syanao-coder/cat-toy/README.md

# cat-toy — 猫を見つけて、その前方をレーザーで照らす自動おもちゃ

壁の高い位置に取り付けたカメラで猫を見つけ、パン・チルトのサーボで動かすレーザーを**猫の少し前方**に照らして遊ばせます。
猫の認識は常時起動している **NAS のコンテナ**（GPU 対応）で行い、壁に付けるのは安価な**カメラ付き ESP32** だけです。
スマホのホーム画面に追加できる操作画面から ON/OFF できます。

```
 壁の上（部品代 5 千円前後）                              NAS（QNAP Container Station など）
┌────────────────────────────┐   映像（Wi-Fi）   ┌────────────────────────────────────┐
│ カメラ付き ESP32-S3         │ ───────────────► │ ① YOLO で猫・人を検出（GPU）          │
│  ├ カメラ（固定・部屋全体） │                  │ ② 猫の位置と速度を推定（遅れも補正）   │
│  └ パン・チルト＋レーザー   │ ◄─────────────── │ ③ 遊び方を決める（50 Hz）             │
└────────────────────────────┘   狙い・点灯       │ ④ 画像上の狙い → サーボの角度         │
                                                  │ ⑤ スマホ用の操作画面                  │
                                                  └────────────────────────────────────┘
```

## 特徴

- **猫の前方を狙う**: 猫の速度から進む向きを推定し、その先に光点を置く。止まっている猫には、最後に向いていた方向の少し先で誘う。
- **獲物らしい動き**: 前を逃げる・素早く逃げて止まる・ちょろちょろ動く・一瞬隠れて別の場所に現れる、を組み合わせる。
  飛びかかってきたら基本は逃げるが、ときどきわざと捕まえさせる。
- **安全装置**: 猫の体の周り（目を含む）には照射しない／人が写っている間は消灯／遊ぶ範囲を床の指定範囲に限定／映像の上で囲んだ禁止エリアには照射しない／
  1 回の遊びは 10 分まで → 30 分休憩／動作時間帯の指定／連続点灯時間の上限／
  通信が 0.3 秒途絶えたら ESP32 が自分でレーザーを消す。
- **自動キャリブレーション**: レーザーを格子状に点滅させてカメラで位置を測り、「画像の位置 → サーボ角度」と映像の遅れを自動で求める。
- **スマホで操作**: ON/OFF・状態・今日遊んだ時間・ライブ映像。ESP32 の BOOT ボタンでも ON/OFF できる。
- **設置したまま更新**: ESP32 のファームウェアはネットワーク越しに書き換えられ、起動に失敗したら自動で前の版に戻る。
  Wi-Fi が変わっても、設定用のアクセスポイントからつなぎ直せる。
- **NAS に優しい**: OFF・休憩中は認識を止め、猫がいない間は 1 秒に 1 回だけ確認する。認識は GPU（なければ自動で CPU）。

## ⚠️ 安全について（必ずお読みください）

- **レーザーは出力 1mW 以下（Class 2 以下）のものを使ってください。** 電子工作用のレーザーモジュールは 5mW 品が多く危険です。
- ソフトウェアで猫の体の周りを避けていますが、検出漏れや遅れはゼロにはできません。
  照射範囲（サーボの可動範囲と `play_area`）は**床だけ**に絞り、人や猫の目の高さに届かないようにしてください。
- 最初の数日は必ず人が見ている所で動かし、猫の反応と動作を確認してから無人運転にしてください。
- 鏡・窓・ガラスなど反射する物に当たらないように設置してください。届いてしまう物は、操作画面で**禁止エリア**の枠で囲んでください。
  禁止エリアもカメラの認識と位置合わせの精度に頼っているので、可動範囲で届かないようにするのがいちばん確実です。
- レーザー遊びは「捕まえられない」ことで猫がストレスを溜めることがあると言われます。
  `finish_point` に本物のおもちゃやおやつを置き、最後はそこで「捕まえて」終われるようにするのがおすすめです。

## 作り方

| 手順 | 内容 | 説明 |
| --- | --- | --- |
| 1. 部品をそろえて組み立てる | ESP32-S3 CAM・OV2640 120°・MG90S ×2・パン・チルト台・1mW レーザーなど | [docs/hardware.md](docs/hardware.md)（プリント基板にするなら [docs/pcb.md](docs/pcb.md)） |
| 2. ESP32 に書き込む | Arduino IDE で `firmware/cattoy_esp32` を書き込む | [firmware/README.md](firmware/README.md) |
| 3. NAS にアプリを作る | Container Station に [YAML](docker/qnap-app.yml) を貼り付ける（2 行だけ書き換え） | [docs/nas.md](docs/nas.md) の 1〜2 |
| 4. 調整する | 操作画面で可動範囲の調整 → 位置合わせ（キャリブレーション） | [docs/nas.md](docs/nas.md) の 3 |
| 5. スマホから使う | `http://<NAS の IP>:8090/` をホーム画面に追加 | [docs/nas.md](docs/nas.md) の 4 |

NAS がない場合は、Raspberry Pi 1 台で完結させる構成でも動きます（[docs/raspberry-pi.md](docs/raspberry-pi.md)）。

## コマンド

| コマンド | 内容 |
| --- | --- |
| `cattoy run` | 遊ばせる（本番）。操作画面も出す |
| `cattoy calibrate [-y] [--web PORT]` | カメラとサーボの対応付けと映像の遅れを自動で測る（猫と人がいない状態で） |
| `cattoy hw-test [--laser]` | 配線確認（レーザーの点滅とサーボを可動範囲の端まで動かす） |
| `cattoy aim --angles PAN TILT` / `--point X Y` | 指定した角度・画像上の位置を照らす |
| `cattoy snapshot` | 目盛り付きのカメラ画像を保存する |
| `cattoy esp32-update FILE` | ESP32 のファームウェアをネットワーク越しに書き換える（失敗したら自動で前の版に戻る） |
| `cattoy esp32-status` / `esp32-reboot` | ESP32 の状態を見る／再起動する |
| `cattoy esp32-wifi SSID` | ESP32 がつなぐ Wi-Fi を変える |

コンテナでは `docker compose -f docker/compose.yml run --rm cattoy <コマンド>` で実行します。

## 遊び方の調整

`config.toml` の `[play]` で変えられます（すべての項目と既定値は [cattoy/config.py](cattoy/config.py)）。
距離と速さは**猫の体長を 1 とした倍率**なので、設置の高さやカメラの画角が変わってもそのまま使えます。

| 項目 | 既定値 | 内容 |
| --- | --- | --- |
| `session_max_s` / `cooldown_s` | 600 / 1800 | 1 回の遊びの長さと、その後の休憩（秒） |
| `active_hours` | `"07:00-23:00"` | 動作する時間帯（`""` で常時） |
| `start_delay_s` | 1.5 | 猫がこの秒数見え続けたら開始（誤検出対策） |
| `keepout_margin` | 0.35 | 猫の外接矩形をこれだけ広げた範囲には照射しない |
| `lead_distance` | 1.6 | 走る猫のどれだけ前に置くか |
| `lure_distance` | 2.0 | 止まった猫のどれだけ前で誘うか |
| `creep_speed` / `move_speed` / `dart_speed` | 0.8 / 2.5 / 7.0 | ゆっくり／ふつう／素早い動きの速さ（体長/秒） |
| `flee_probability` | 0.7 | 飛びかかられたとき逃げる確率（残りはわざと捕まえさせる） |
| `person_safety` | true | 人が写っている間は消灯 |
| `play_area` / `finish_point` | 自動 / なし | 遊ぶ範囲（多角形）と、終わりに誘導する場所 |
| `no_go_zones` / `no_go_margin` | なし / 0.02 | レーザーを当てない四角（窓・テレビなど）と、その周りに空ける余白（画像の幅に対する割合）。**操作画面のライブ映像の上で枠を置いて設定できる** |

## 実機なしで試す（PC）

USB カメラや猫の動画ファイルを使って、検出と遊び方の判断をブラウザで確認できます（サーボとレーザーは動かしません）。

```bash
pip install -e '.[desktop]'
cat > config.toml <<'EOF'
[camera]
backend = "opencv"
device = 0              # 動画ファイルなら "cat.mp4"
[servo]
backend = "mock"
[laser]
backend = "mock"
[play]
active_hours = ""
EOF
cattoy run      # http://localhost:8080/ を開く
```

検出モデルは、コンテナを使わない場合だけ自分で用意します（`models/yolo11n.onnx` に置く）。

```bash
pip install ultralytics
yolo export model=yolo11n.pt format=onnx imgsz=320
```

> Ultralytics のモデルは AGPL-3.0 ライセンスです。個人で使う分には問題ありません。

## 開発

```bash
pip install -e '.[dev]'
pytest
```

テストでは次のことを確認しています。
- レーザー点を追いかける仮想の猫で、点灯中は必ず猫から離れた位置・遊ぶ範囲の中を照らしていること
- 仮想の部屋（壁掛けのパン・チルト＋広角カメラ）での自動キャリブレーションの精度と、映像の遅れの測定
- ESP32 との通信（ローカルの UDP / HTTP サーバー相手）、本物の onnxruntime での検出
- 本体ループの ON/OFF・待機中の認識間隔・操作画面の API

| ファイル | 役割 |
| --- | --- |
| `cattoy/app.py` | 本体ループ（映像スレッド＋50 Hz の制御ループ、ON/OFF、負荷の段階切り替え） |
| `cattoy/behavior.py` | 遊び方のステートマシン（狙いの位置・点灯の判断、安全装置） |
| `cattoy/tracker.py` | 猫の追跡（位置・速度の推定と外挿） |
| `cattoy/detector.py` | YOLO（ONNX）による猫・人の検出（GPU / CPU） |
| `cattoy/calibration.py` | 画像座標 ⇔ サーボ角度の対応付け、レーザー点の検出 |
| `cattoy/calibrate.py` | 自動キャリブレーションの手順と映像の遅れの測定 |
| `cattoy/esp32.py` | ESP32 との通信（映像の受信、サーボ・レーザーの指令） |
| `cattoy/firmware.py` | ESP32 の遠隔メンテナンス（ファームウェアの書き換え・再起動・Wi-Fi 設定） |
| `cattoy/hardware.py` | カメラ・サーボ・レーザーの共通部分（Raspberry Pi 用とモックを含む） |
| `cattoy/preview.py` / `webpage.py` | 操作画面とライブ映像 |
| `cattoy/cli.py` | コマンド |
| `firmware/cattoy_esp32/` | ESP32 のファームウェア（Arduino） |
| `docker/` | コンテナ（GPU 版・CPU 版）、Container Station 用の YAML、compose 設定 |
| `.github/workflows/` | テストと、コンテナイメージの自動作成（ghcr.io） |

## 今後の拡張案

- **閉ループ補正**: 遊んでいる最中もレーザー点をカメラで確かめ、狙いのずれを補正する。
- **多頭飼い対応**: 現在は 1 匹を追いかける（2 匹以上いるときは直前に追っていた猫を優先）。
