syanao-coder/cat-toy/docs/hardware.md

# ハードウェア（部品・配線・設置）― ESP32 構成

壁に付けるのは「カメラ付き ESP32 ＋ パン・チルト台に載せたレーザー」だけです。猫の認識は NAS のコンテナが行います。

```
  ┌─────────── ケース（壁に固定） ───────────┐
  │  [カメラ] ← 固定。部屋全体を見渡す          │
  │  [ESP32-S3 ボード]                          │
  │  [パン・チルト台] ← ここだけ動く            │
  │      └ [レーザー]                          │
  └─────────────────────────────────────────────┘
```

## 部品

| 部品 | 選んだもの | 数 | メモ |
| --- | --- | --- | --- |
| カメラ付きマイコン | **ESP32-S3 CAM（ESP32-S3-WROOM-1 N16R8、USB-C ×2）** | 1 | Freenove ESP32-S3-WROOM CAM 互換の配置。カメラ別売りの「Single module」で可 |
| カメラ | **OV2640 120° レンズ版（24 ピン、ケーブル 75mm）** | 1 | 赤外線カット付きの通常版（「850nm」「Night Vision」版は避ける） |
| サーボ | **MG90S（金属ギア、180°）** | 2 | 「360°（連続回転）」版は使えない。予備に 1 個あると安心 |
| パン・チルト台 | SG90 / MG90S 用 2 軸ブラケット | 1 | サーボの付属ホーンを切って合わせるのが普通 |
| レーザー | 赤色 650nm **1mW 以下** | 1 | 秋月電子「赤色ドットレーザーモジュール 8mm×19mm 1mW」を推奨（下記） |
| トランジスタ | 2SC1815 ＋ 1kΩ 抵抗 ＋ 10kΩ 抵抗 | 各 1 | レーザーの ON/OFF 用（10kΩ は起動中にレーザーが勝手に点かないようにする） |
| 電源 | 5V 2A 以上の AC アダプター | 1 | サーボ 2 個とボードをまとめて給電する |
| コンデンサ | 電解コンデンサ 470〜1000µF（10V 以上） | 1 | サーボが動き出すときの電圧低下でボードが再起動するのを防ぐ |
| 有線 LAN 用の口 | ピンヘッダー（メス）1×8 ＋ 10kΩ 抵抗 | 各 1 | 後から W5500 を挿せるようにしておく（下記「有線 LAN 用の口」） |
| その他 | ユニバーサル基板（またはプリント基板 → [pcb.md](pcb.md)）・ジャンパワイヤ・ケース・固定具 | | |
| （後から）有線 LAN | W5500 モジュール | 1 | 必要になったら足す。5V ピンのある（レギュレーター付きの）ものが扱いやすい |

### レーザーの選び方

- **必ず出力 1mW 以下（JIS / IEC の Class 1 または 2）を選んでください。**
  電子工作用の「レーザーダイオードモジュール」は 5mW（Class 3R）のものが多く、猫にも人にも危険です。
- 通販のノーブランド品は表記より出力が強いことがあります。出力が明記されている国内の電子部品店の品が確実です。
- 赤（650nm）が一般的です。猫は赤を見分けにくいとも言われますが、動く光点にはよく反応します。

## 配線

後から有線 LAN（W5500）を足せるように、**最初から「有線 LAN 用の口」（8 ピンのヘッダー）を用意しておく**配線です。
W5500 を挿さなければ今までどおり Wi-Fi で動き、挿せばケーブルを挿すだけで有線にできます（ファームウェアが自動で切り替える予定）。

### 配線図

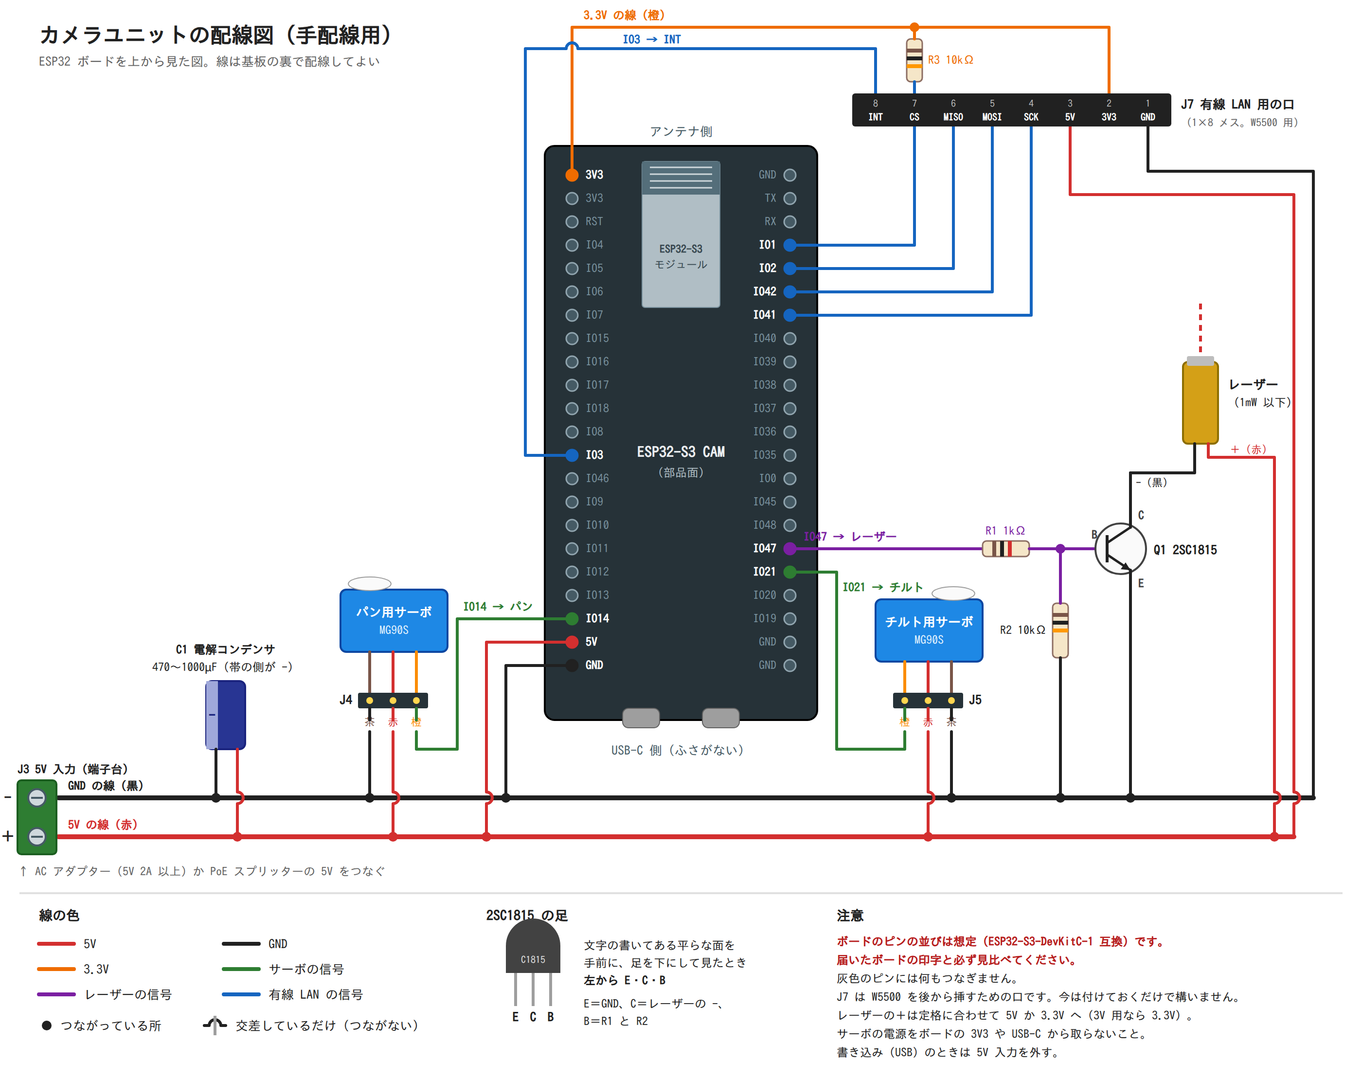
[picture p1: docs/images/wiring.png]
カメラユニットの配線図


（拡大して見たいときは [SVG 版](images/wiring.svg)。ピンの並びが違って作り直すときは `python docs/images/wiring_diagram.py`）

- 赤＝5V、黒＝GND、橙＝3.3V。**●** はつながっている所、**半円で飛び越えている所**は交差しているだけ（つながない）です。
- 下の 2 本（5V の線と GND の線）は、ユニバーサル基板の端に沿って太めの線を 2 本通し、各部品をそこへつなぐ形にすると配線が楽です。
- ボードのピンの並びは **ESP32-S3-DevKitC-1 互換の想定**です。届いたボードの印字と必ず見比べてください。

### 組み立ての順番（ユニバーサル基板）

1. **ESP32 ボード用のメスのピンヘッダー 2 列**を先に付ける。ボードを挿した状態ではんだ付けすると、列の間隔がずれない
   （はんだ付けの熱が伝わらないよう、1 列の両端だけ留めたらボードを抜いて残りを付ける）。
   ボードのアンテナ側の端は、ユニバーサル基板の外にはみ出すように置くと電波が弱まりにくい。
2. **5V の線と GND の線**を基板の端に沿って 2 本通す（太さ 0.3mm² 以上、または AWG22 程度。サーボで 2A 近く流れる）。
3. **端子台（J3）・電解コンデンサ（C1）・サーボの口（J4・J5）**を付けて、5V の線と GND の線へつなぐ。
4. **ボードの 5V・GND**（左列の下 2 本）を 5V の線と GND の線へつなぐ。
5. **信号線**（IO14・IO21・IO47）と、**レーザーの部分**（R1・R2・Q1）を付ける。信号線は細い線（AWG26〜28 やポリウレタン線）でよい。
6. **有線 LAN 用の口（J7）・R3** と、3.3V・IO1・IO2・IO3・IO41・IO42 の線を付ける。今は W5500 を挿さないので、付けておくだけで構いません。
7. **電源を入れる前に、テスターで確かめる**:
   - 5V の線と GND の線の間が導通していない（ショートしていない）
   - ボードの 5V ピン・3V3 ピン・GND ピンが、それぞれ正しい線とつながっている
   - 2SC1815 の向き（平らな面を手前に、左から E・C・B）
8. **ESP32 ボードを挿さずに 5V 入力をつなぎ**、ボードの 5V ピンの所に 5V が来ていることをテスターで確かめる。
9. 5V 入力を外してから ESP32 ボードを挿し、USB でファームウェアを書き込む（[firmware/README.md](../firmware/README.md)）。
10. USB を外して 5V 入力から動かし、操作画面の「調整」で、スライダーでサーボが動くこと・「レーザーを点ける」でレーザーが点くことを確かめる。

### 全体

```
 5V 入力（AC アダプター／PoE スプリッター）
   │
 ┌─┴──────── 中継基板 ────────────┐
 │ 5V・GND ─┬─ ESP32 ボード          │
 │          ├─ サーボ ×2            │
 │          ├─ 電解コンデンサ        │
 │          ├─ レーザー（2SC1815）   │
 │          └─ 有線 LAN 用の口       │
 │                                  │
 │ ESP32 ボード                     │
 │   GPIO14・21 → サーボの信号      │
 │   GPIO47     → レーザーの ON/OFF │
 │   GPIO41・42・2・1・3            │
 │              → 有線 LAN 用の口   │
 └──────────────┬───────────────────┘
                └─（後から）W5500 ─ LAN ケーブル
```

### 電源とサーボ

```
  5V 入力 (+) ──┬──────────────┬──────────────┬───────────────┬─── ボードの 5V ピン
                │              │              │               │
            パン用サーボ    チルト用サーボ   ＋ 電解コンデンサ   有線 LAN 用の口 3 番（5V）
              赤線            赤線         （足の長い方）
  5V 入力 (−) ──┴── 茶線 ──────┴── 茶線 ──────┴── − 側 ────────┴─── ボードの GND ピン

  ボード GPIO14 ──────────── パン用サーボのオレンジ線（信号）
  ボード GPIO21 ──────────── チルト用サーボのオレンジ線（信号）
```

- 5V 入力は、AC アダプターでも、PoE スプリッターの 5V 出力でも同じ所につなぎます。
- **GND（−）はすべてつなげます。** 電源・サーボ・ボード・トランジスタ・W5500 の GND が共通でないと動きません。
- サーボの電源はボードの 3.3V から取らないでください（電流が足りずボードが落ちます）。
  ボードの USB-C を通してサーボに給電するのも避けます（ボードの配線が電流に耐えられません）。
- コンデンサには向きがあります（足の短い方・帯の側が −）。逆につなぐと壊れます。
  サーボの近く（5V と GND が分かれる所）に付けると効きます。

### レーザー

```
  ボード GPIO47 ── 1kΩ ──┬── B ┐
                         │     │  2SC1815（NPN）
                       10kΩ    │  ※足は平らな面を正面にして左から E・C・B
                         │     │
  ボード GND ────────────┴── E ┤
  レーザー (−) ────────────── C ┘
  レーザー (+) ── 5V または 3.3V（レーザーの定格電圧に合わせる）
```

- 10kΩ はベースと GND の間に入れます。電源を入れた直後や書き込み中は GPIO47 の状態が決まらないので、
  これがないとレーザーが一瞬点くことがあります。

### 有線 LAN 用の口（W5500 を後から挿すためのヘッダー）

1×8 のメスのピンヘッダーを中継基板に付けて、次のようにボードとつないでおきます。
W5500 はジャンパワイヤ（オス‐メス）でこのヘッダーとつなぎます。

| 口の番号 | 信号 | つなぐ先（ボード側） | W5500 モジュールの表記の例 |
| --- | --- | --- | --- |
| 1 | GND | GND | GND |
| 2 | 3.3V | 3V3 | 3.3V / 3V3 / VCC |
| 3 | 5V | 5V | 5V（ないモジュールもある） |
| 4 | SCK | GPIO41 | SCK / SCLK |
| 5 | MOSI | GPIO42 | MOSI / SI |
| 6 | MISO | GPIO2 | MISO / SO |
| 7 | CS | GPIO1（**10kΩ で 3.3V へつなぐ**） | CS / SCS / SS |
| 8 | INT | GPIO3 | INT |

- **W5500 の電源は 2 番（3.3V）か 3 番（5V）のどちらか一方だけ**につなぎます。
  - 5V ピンのある（レギュレーター付きの）モジュールなら **3 番の 5V** から。ボードの 3.3V の負担が増えません。
  - 3.3V しかない小型のモジュール（W5500 Lite など）は 2 番の 3.3V から。W5500 は 130mA ほど使うので、有線のときは Wi-Fi を止めて合計を抑えます（ファームウェアで対応）。
- W5500 の RST（リセット）はつながなくて構いません（ファームウェアが通信でリセットします）。
- 7 番の CS には **10kΩ の抵抗を 3.3V との間に**入れておきます（電源を入れた瞬間に W5500 が誤動作しないように）。
- **W5500 までの線は 15cm 以内**にしてください。速い信号（20MHz）なので、長いと通信が不安定になります。
- W5500 を挿していなくても、この口は付けたままで問題ありません（ファームウェアが W5500 の有無を確かめて、なければ Wi-Fi で動きます）。

### ピンの使い方（まとめ）

| GPIO | 用途 |
| --- | --- |
| 4〜13・15〜18 | カメラ（ボード上で配線済み） |
| 14 / 21 | パン / チルト用サーボ |
| 47 | レーザー（2SC1815 経由） |
| 0 | BOOT ボタン（ON/OFF） |
| 48 | ボード上の RGB LED |
| 41 / 42 / 2 / 1 / 3 | **有線 LAN 用に予約**（SCK / MOSI / MISO / CS / INT） |
| 35〜37 | **使用禁止**（内蔵メモリ PSRAM） |
| 38〜40 | 使わない（ボードの microSD スロットにつながっている） |
| 19 / 20 | 使わない（USB-C の「USB」側） |
| 43 / 44 | 使わない（USB-C の「COM」側＝書き込み用） |
| 45 / 46 | 使わない（起動のしかたを決めるピン。つなぐ物によっては起動しなくなる） |

※ ピンの名前の位置はボードの製品によって違うことがあります。届いたら、ボードの印字で GPIO1・2・3・41・42 がピンヘッダーに出ていることを確かめてください。

### その他

- この配線をプリント基板にする手順は [pcb.md](pcb.md) にあります（EasyEDA での描き方・接続表・回路図の照合）。
- **書き込み（USB 接続）のときは 5V 入力を外しておく**と安全です。
- ON/OFF ボタンには、ボード上の **BOOT ボタン**を使います（押すたびに ON/OFF が切り替わります）。
  手の届く所に置きたい場合は、タクトスイッチを GPIO0 と GND の間に配線して延長できます
  （電源を入れる瞬間に押していると書き込みモードで起動するので注意）。

## 設置

```
     壁
     ┃ ◢ ケース（高さ 2m 以上・部屋の中央に向けて斜め下向き）
     ┃   ＼
     ┃     ＼   ← 斜めに見下ろす
     ┃       ＼
     ┗━━━━━━━━━━━━━━━━━━━━━━━  床（ここで遊ぶ）
```

- **高い壁面（部屋の角が理想）から、部屋の中央に向けて斜め下に**取り付けるのがおすすめです。
  - 物体検出モデルは普通の写真で学習しているため、真上から見下ろすより斜めから見たほうが猫を見つけやすい。
  - パン・チルト台を真下に向けると、真下付近でパンの回転が効かなくなり、狙いが不安定になる。
- **カメラは動かさず固定します。** 動くのはパン・チルト台のレーザーだけです。
  カメラ画像の座標とサーボの角度の対応表（キャリブレーション）を作るので、カメラが動くと狙いが合わなくなります。
- カメラはパン・チルト台の土台の近くに、部屋全体が写る向きで固定します。近いほど、ソファの上など床より高い場所での狙いのずれが小さくなります。
- カメラのケーブルは曲げを繰り返すと傷むので、動く部分には載せず、ケースにしっかり固定してください。
- 取り付けがずれたら `cattoy calibrate` をやり直します。
- 猫が登って届く場所・ケーブルを噛める場所は避けてください。
- 鏡・窓・テレビ・ガラスのテーブルなど、光を反射する物にレーザーが当たらない向きにします。
- Wi-Fi の電波が届く場所にしてください（操作画面に ESP32 の電波強度が出ます。-70 dBm より弱いと映像が途切れがちになります）。
  電波が弱い場合は、「有線 LAN 用の口」に W5500 を挿して有線にできます。
