syanao-coder/cat-toy/models/README.md

# 検出モデル

ここに YOLO の ONNX モデル（既定のファイル名は `yolo11n.onnx`）を置きます。
コンテナで動かす場合は同梱されているので不要です。それ以外の作り方は README.md の「実機なしで試す」を参照してください。
