syanao-coder/cat-toy/docs/images/wiring_lan.png

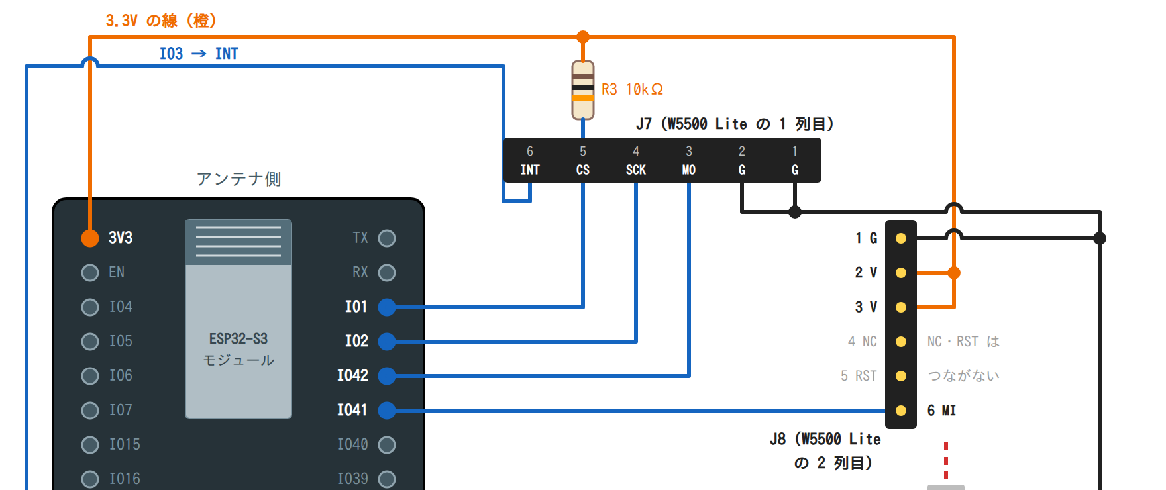
docs/images/wiring_lan.png
