syanao-coder/cat-toy/docs/images/wiring_power.png

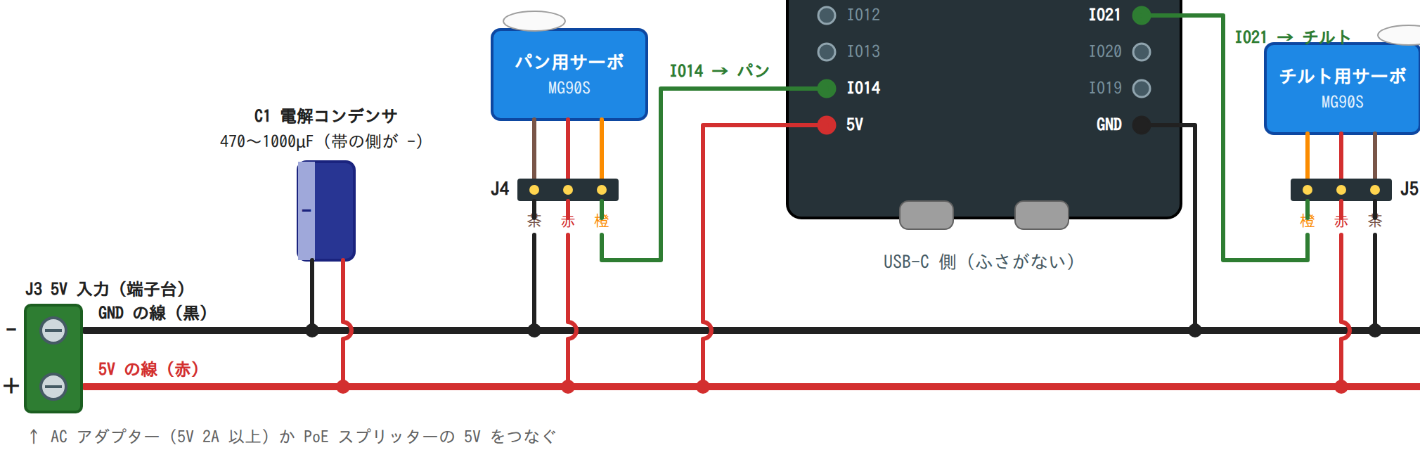
docs/images/wiring_power.png
