syanao-coder/cat-toy/(commit log)

2026-10-06 猫を認識してその前方をレーザーで照らす自動おもちゃ（NAS コンテナ＋カメラ付き ESP32） (#1)
    Claude-Session: https://claude.ai/code/session_01XHzioAdkKKiKB35yWGwZda
2026-10-06 Container Station で受け付けられない CPU・メモリの上限を YAML から外す (#2)
    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
2026-10-06 GPU で認識されない問題の修正（onnxruntime-gpu を CUDA 12 用の版に固定） (#3)
    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
2026-10-08 後から W5500（有線 LAN）を足せる配線にする (#4)
    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
2026-10-11 中継基板を EasyEDA で作るための手順書と、回路図の照合スクリプト (#5)
    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
2026-10-14 手配線用の、図入りの配線図 (#6)
    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
2026-10-22 手順書の文字で描いた図をすべて画像にする (#7)
    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
2026-10-22 届いた ESP32 ボードと W5500 Lite に合わせて、基板の設計と配線を直す (#8)
    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
2026-10-22 基板の設計資料と照合スクリプトを EasyEDA の部品の番号に合わせる (#9)
    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
2026-10-22 照合スクリプトが、描いた回路図の記号・ピンの並びのまま照合できるようにする (#10)
    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
2026-10-22 EasyEDA の操作手順を追加し、実物のネットリストで照合スクリプトを直す (#11)
    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
2026-10-22 照合スクリプト: R3 と R4 の番号が逆でも通す (#12)
    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
2026-10-23 PCB 手順書: W5500-LITE の足の形の番号が逆な件と、実際の配置を追記 (#13)
    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
2026-10-24 ファームウェア: W5500 があれば有線 LAN で動く＋CI でコンパイルを確かめる (#14)
    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
2026-10-24 操作画面のライブ映像の上で、禁止エリア（四角・複数）を設定できるようにする (#15)
    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
